IowaScaledEngineering/ckt-soundplay/doc/img/ckt-soundplay.png

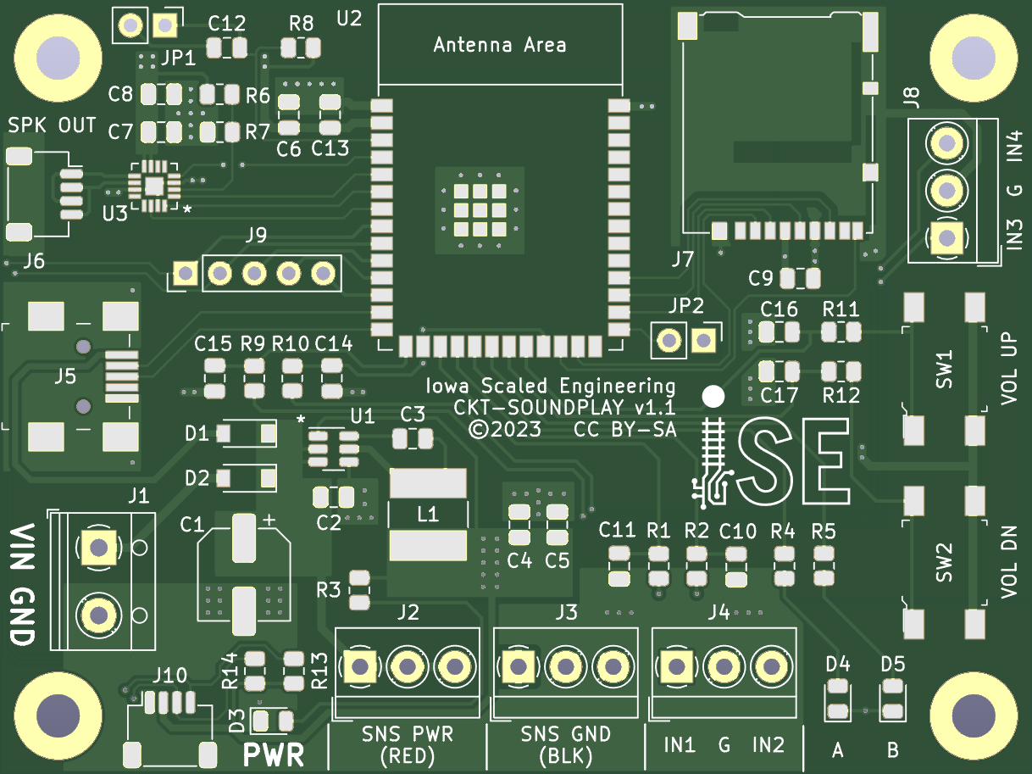
doc/img/ckt-soundplay.png
