IowaScaledEngineering/ckt-soundplay/pg/ckt-soundplay-test-v1.2-57295ef/ckt-soundplay-test-drc.txt

** Drc report for /tank/data/design/projects/ckt-soundplay/kicad/ckt-soundplay-test/ckt-soundplay-test.kicad_pcb **
** Created on 2023-08-12 13:44:06 **

** Found 0 DRC violations **

** Found 0 unconnected pads **

** Found 0 Footprint errors **

** End of Report **
