IowaScaledEngineering/ckt-soundplay/pg/ckt-soundplay-test-v1.2-57295ef/ckt-soundplay-test.pdf

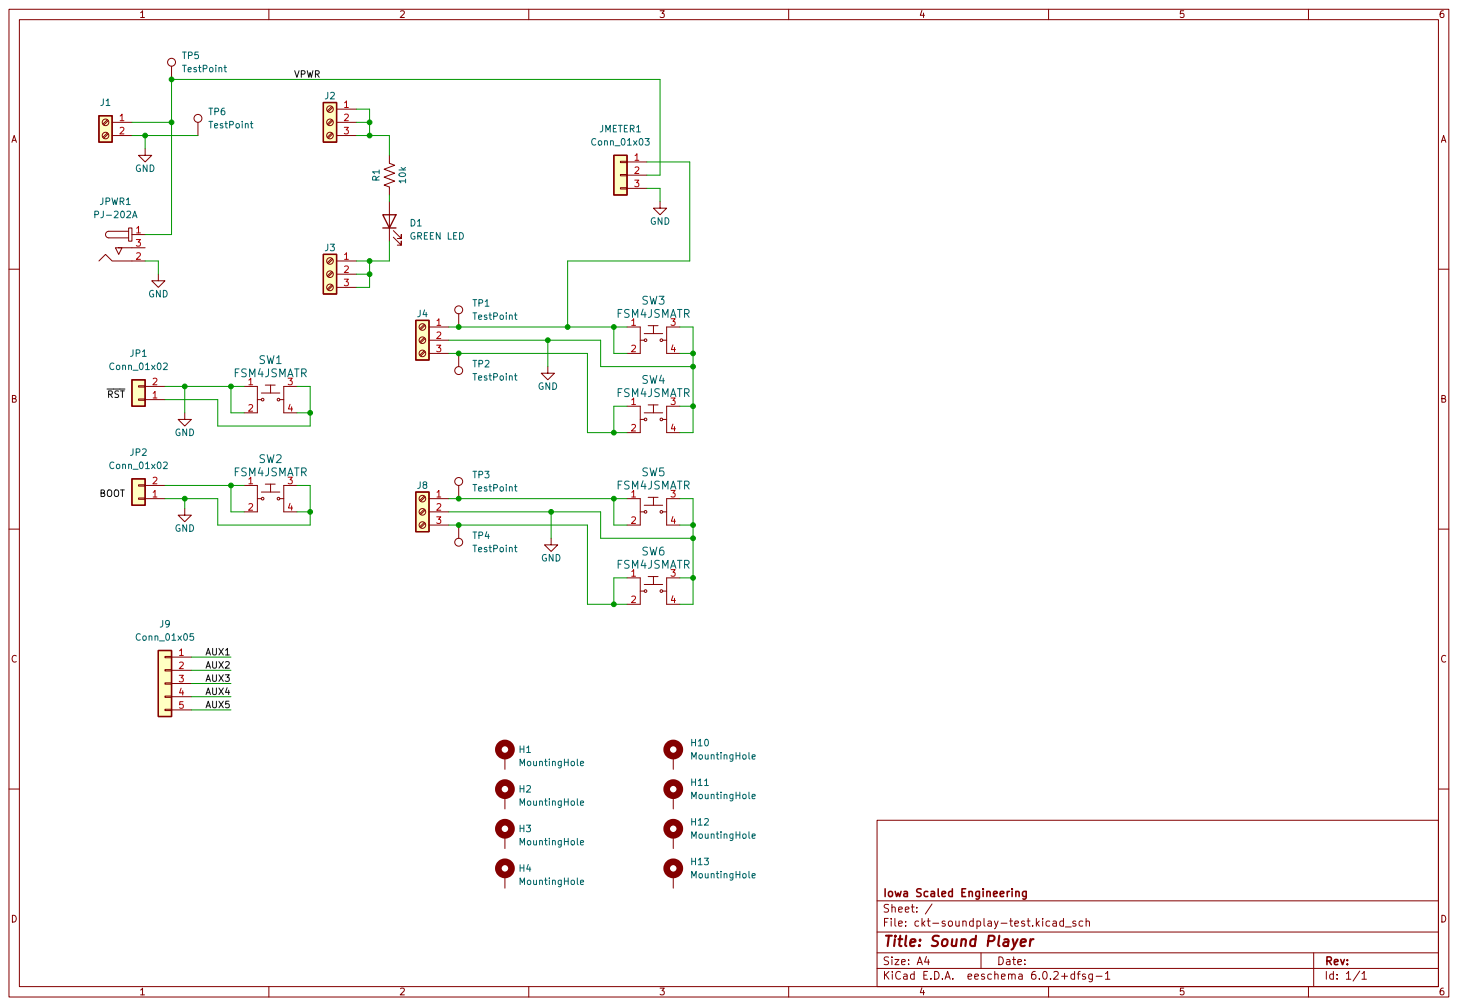
[picture p2: page 1]

H13 MountingHole H10 MountingHole H11 MountingHole H12 MountingHole H3MountingHole H4MountingHole H2MountingHole 123

File: ckt-soundplay-test.kicad_sch Sheet: /
Id: 1/1 Title: Sound Player
