IowaScaledEngineering/ckt-soundplay/pg/ckt-soundplay-v1.2-6501b10/ckt-soundplay.pdf

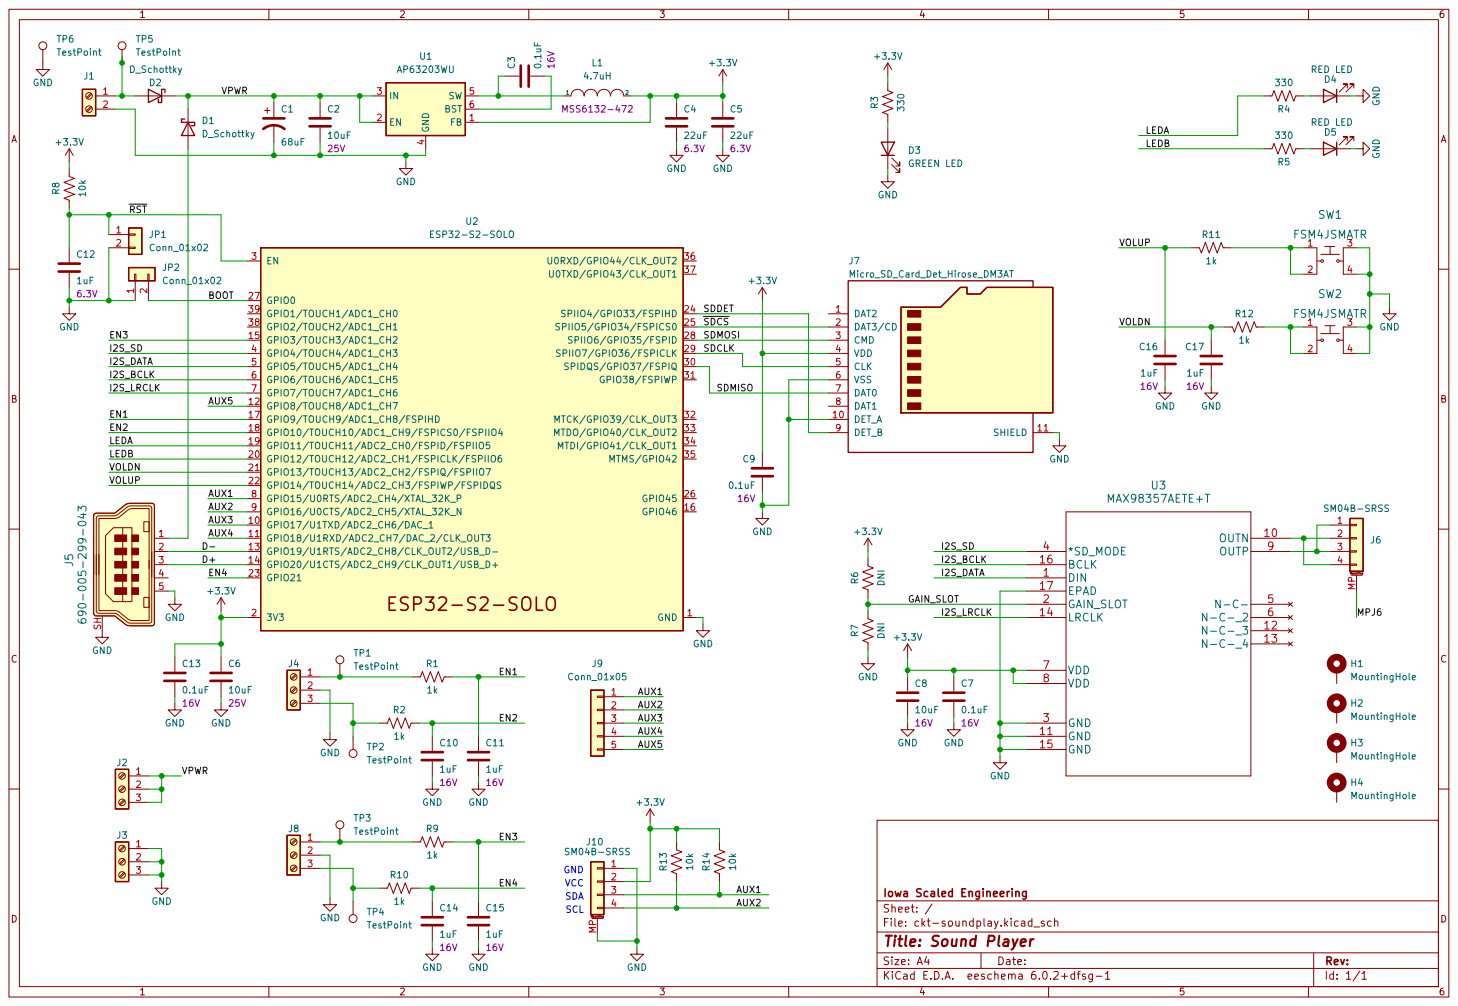
[picture p3: page 1]

File: ckt-soundplay.kicad_sch Sheet: /
Id: 1/1 Title: Sound Player
