IowaScaledEngineering/ckt-soundplay/pg/ckt-soundplay-array-v1.3-4f5287e/ckt-soundplay.pdf

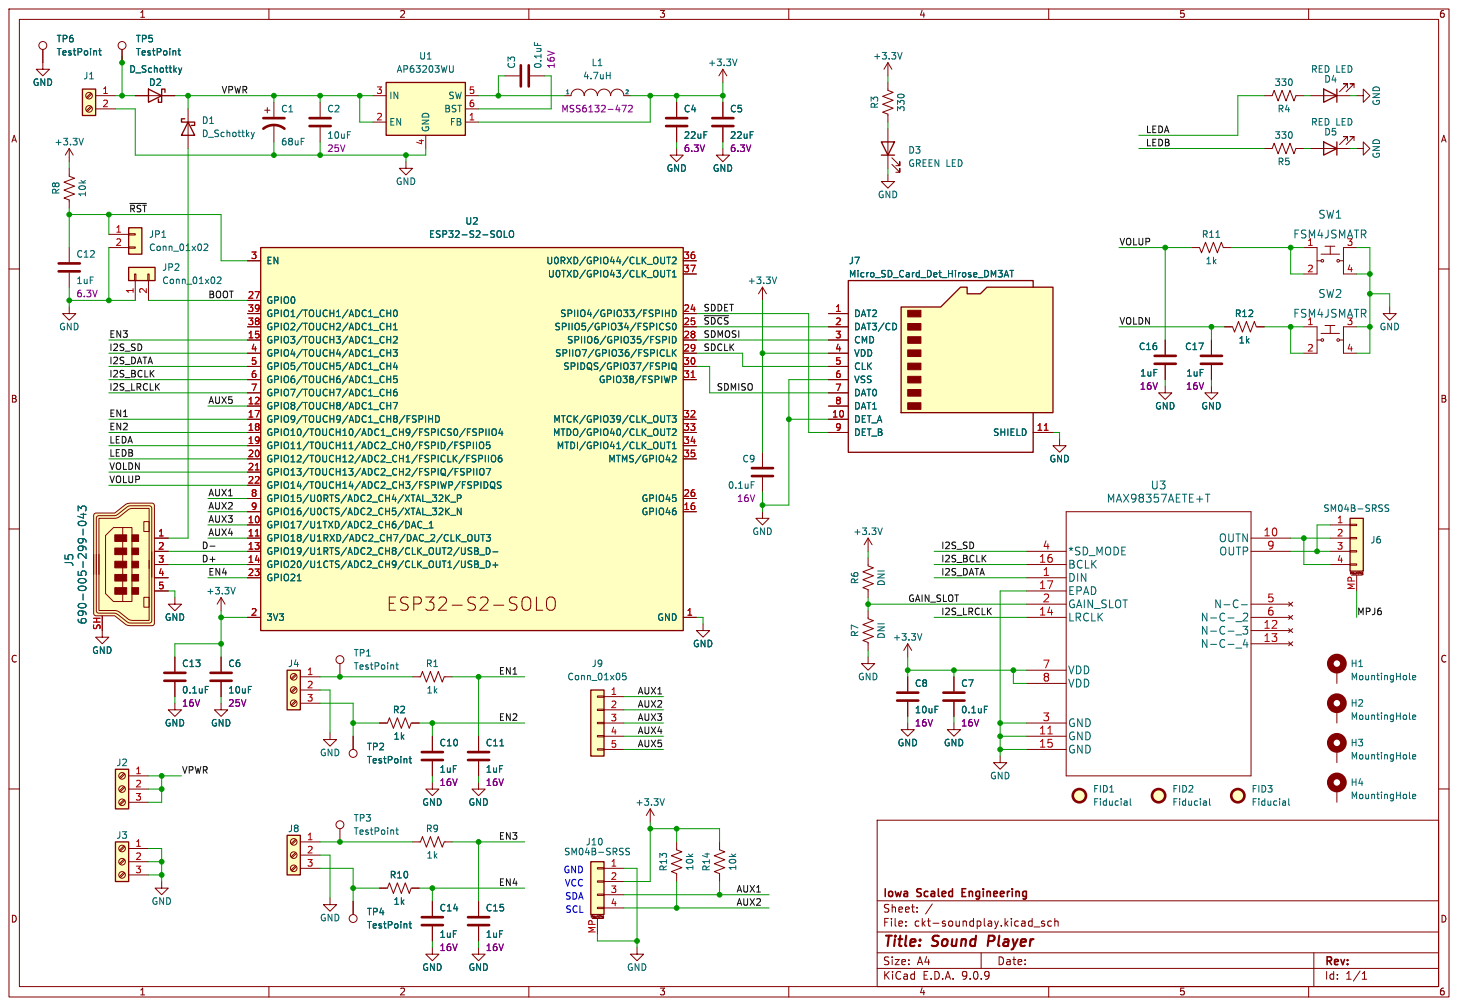
[picture p4: page 1]

EN 3 GPIO0 27 GPIO1/TOUCH1/ADC1_CH0 39 GPIO2/TOUCH2/ADC1_CH1 38 GPIO3/TOUCH3/ADC1_CH2 15 GPIO4/TOUCH4/ADC1_CH3 4 GPIO5/TOUCH5/ADC1_CH4 5 GPIO6/TOUCH6/ADC1_CH5 6 GPIO7/TOUCH7/ADC1_CH6 7 GPIO8/TOUCH8/ADC1_CH7 12 GPIO9/TOUCH9/ADC1_CH8/FSPIHD 17 GPIO10/TOUCH10/ADC1_CH9/FSPICS0/FSPIIO4 18 GPIO11/TOUCH11/ADC2_CH0/FSPID/FSPIIO5 19 GPIO12/TOUCH12/ADC2_CH1/FSPICLK/FSPIIO6 20 GPIO13/TOUCH13/ADC2_CH2/FSPIQ/FSPIIO7 21 GPIO14/TOUCH14/ADC2_CH3/FSPIWP/FSPIDQS 22 GPIO15/U0RTS/ADC2_CH4/XTAL_32K_P 8 GPIO16/U0CTS/ADC2_CH5/XTAL_32K_N 9 GPIO17/U1TXD/ADC2_CH6/DAC_1 10 GPIO18/U1RXD/ADC2_CH7/DAC_2/CLK_OUT3 11 GPIO19/U1RTS/ADC2_CH8/CLK_OUT2/USB_D- 13 GPIO20/U1CTS/ADC2_CH9/CLK_OUT1/USB_D+ 14 GPIO21 23

Id: 1/1 Title: Sound Player File: ckt-soundplay.kicad_sch Sheet: /
