IowaScaledEngineering/ckt-soundplay/pg/ckt-soundplay-test-v1.0-d255e98/ckt-soundplay-test.pdf

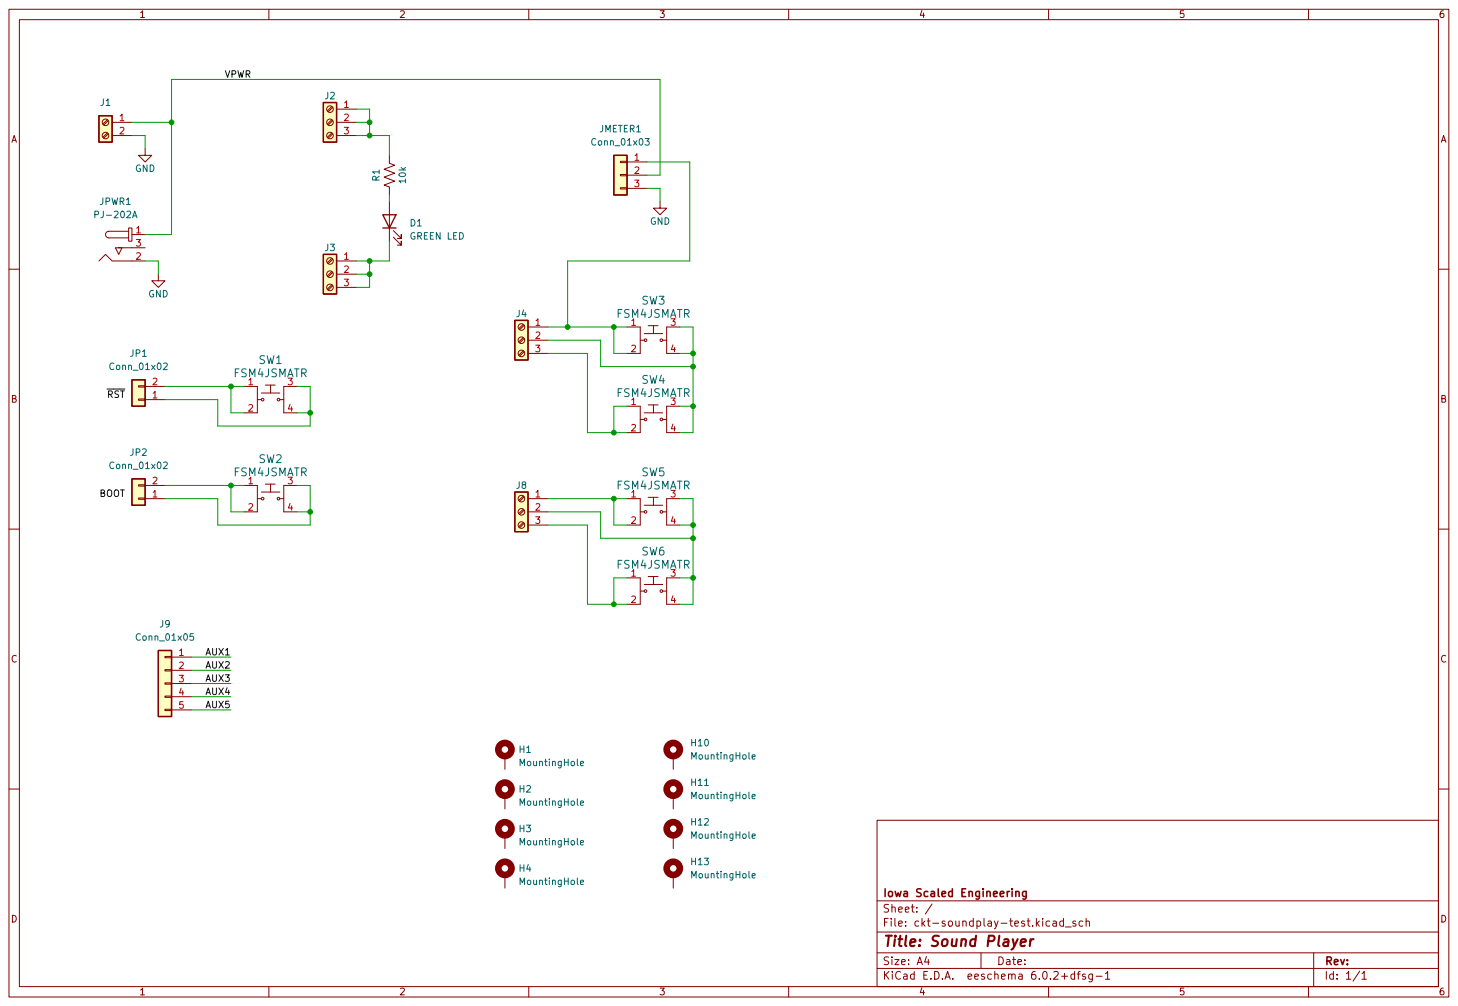
[picture p5: page 1]

Iowa Scaled Engineering
File: ckt-soundplay-test.kicad_sch Sheet: /
Id: 1/1 Title: Sound Player
