IowaScaledEngineering/ckt-soundplay/pg/ckt-soundplay-v1.1-f9cb04d/ckt-soundplay.pdf

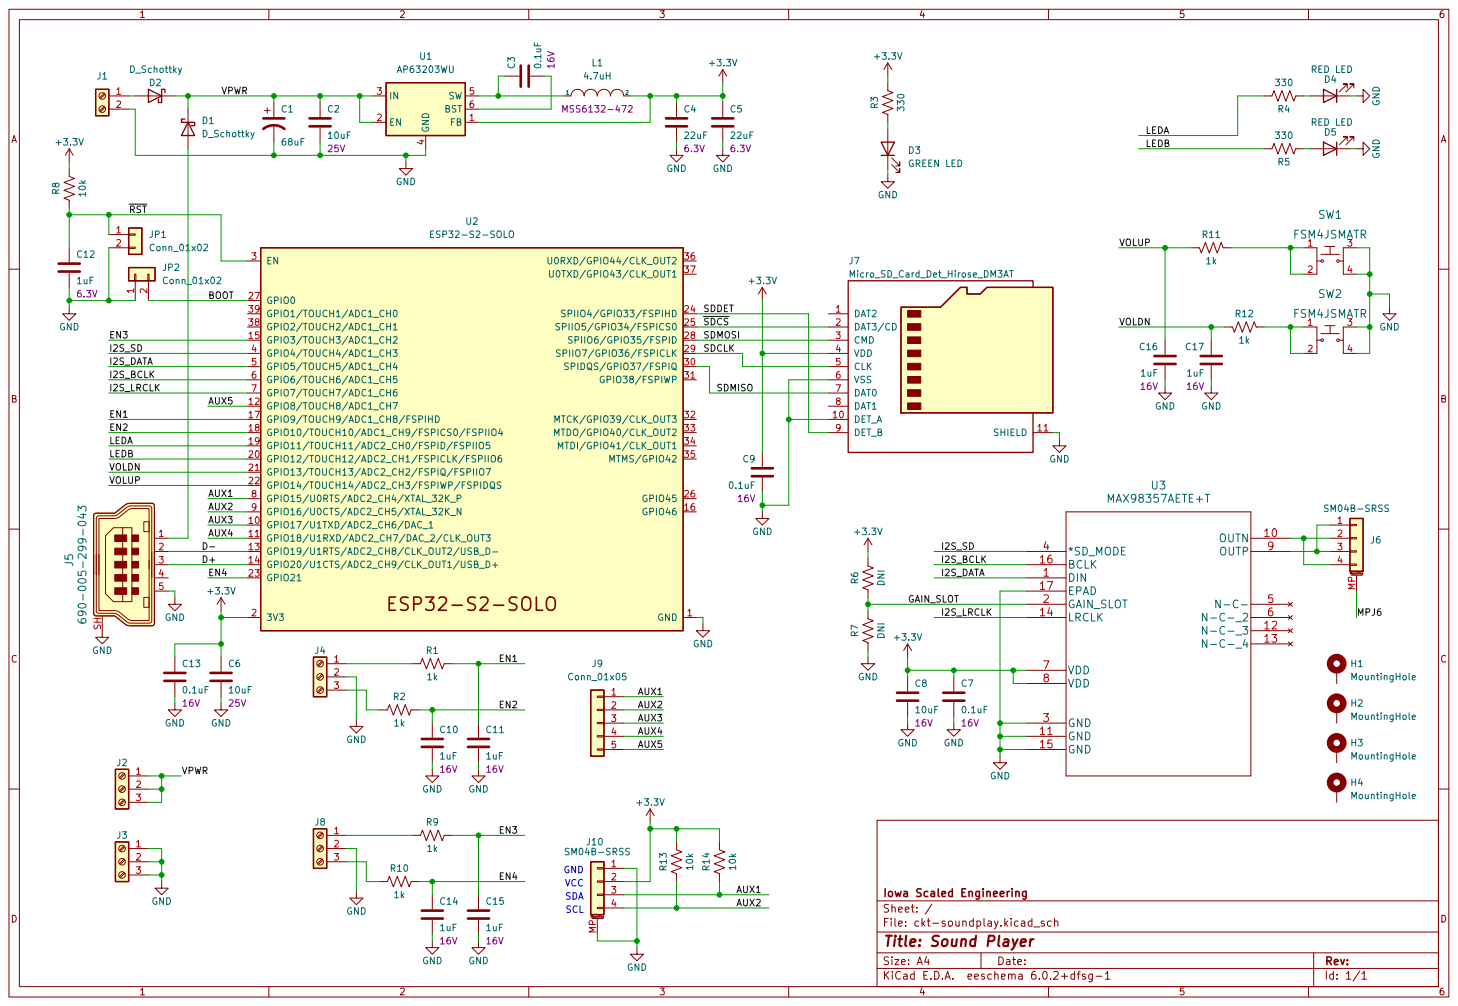
[picture p6: page 1]

SDMOSI
SDCLK

Iowa Scaled Engineering
File: ckt-soundplay.kicad_sch Sheet: /
Id: 1/1 Title: Sound Player
