IowaScaledEngineering/ckt-soundplay/pg/ckt-soundplay-v1.0-2696061/ckt-soundplay.pdf

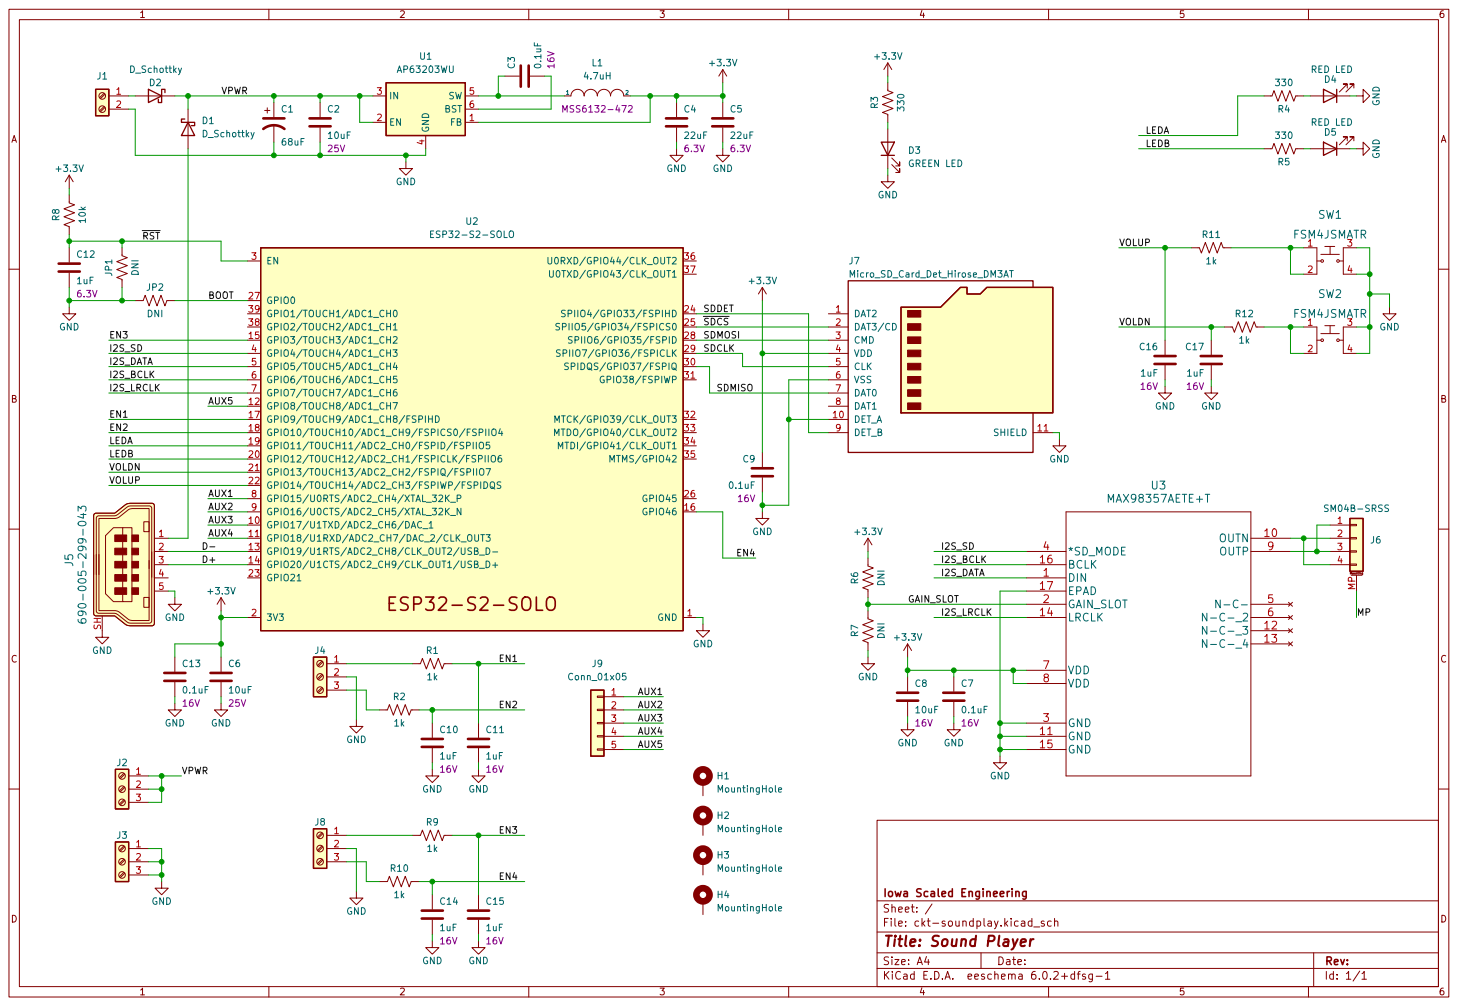
[picture p7: page 1]

Iowa Scaled Engineering
File: ckt-soundplay.kicad_sch Sheet: /
Id: 1/1 Title: Sound Player
