IowaScaledEngineering/ckt-soundplay/(commit log)

2022-11-19 Initial schematic
    [ckt-soundplay.kicad_pcb, ckt-soundplay.kicad_sch]
2022-11-19 Added mounting holes.
    [ckt-soundplay.kicad_sch]
2023-01-02 Initial board design
    [ckt-soundplay.kicad_pcb, ckt-soundplay.kicad_sch]
2023-01-02 Fixed R8/R9 labels
    [ckt-soundplay.kicad_pcb]
2023-01-02 Tweaked R7/D3 positions
    [ckt-soundplay.kicad_pcb]
2023-01-03 Fixed title block text
    [ckt-soundplay.kicad_pcb]
2023-01-03 Minor tweaks
    [ckt-soundplay.kicad_pcb]
2023-01-18 Initial ESP32 version
    [ckt-soundplay.kicad_sch]
2023-01-18 Added reset RC
    [ckt-soundplay.kicad_sch]
2023-01-18 Added reset and bootloader jumpers
    [ckt-soundplay.kicad_sch]
2023-02-21 Partial board update
    [ckt-soundplay.kicad_pcb, ckt-soundplay.kicad_sch]
2023-02-22 Initial layout, still missing I2S lines
    [ckt-soundplay.kicad_pcb, ckt-soundplay.kicad_sch]
2023-02-22 Improved 3.3V plane
    [ckt-soundplay.kicad_pcb]
2023-03-01 Added some net names and tweaked some routing/planes
    [ckt-soundplay.kicad_pcb, ckt-soundplay.kicad_sch]
2023-03-07 Swapped LRCLK and SD, power cleanup around I2S amp
    [ckt-soundplay.kicad_pcb, ckt-soundplay.kicad_sch]
2023-03-12 Added IN3/IN4
    [ckt-soundplay.kicad_pcb, ckt-soundplay.kicad_sch]
2023-03-12 Added J9
    [ckt-soundplay.kicad_pcb, ckt-soundplay.kicad_sch]
2023-03-12 Layout tweaks
    [ckt-soundplay.kicad_pcb]
2023-03-14 Added RC to VOL buttons. GND plane improvements.
    [ckt-soundplay.kicad_pcb, ckt-soundplay.kicad_sch]
2023-03-14 Minor text adjustments
    [ckt-soundplay.kicad_pcb]
2023-03-16 Fixed DRC that kibot found
    [ckt-soundplay.kicad_pcb]
2023-03-25 Sent to fab March 2023
    [ckt-soundplay-NPTH.drl, ckt-soundplay.drl, ckt-soundplay.gbl, ckt-soundplay.gbo, ckt-soundplay.gbp, ckt-soundplay.gbr, ckt-soundplay.gbs, ckt-soundplay.gm1]
2023-06-02 Rerouted IN4 Added I2C connector Added vias around input cap
    [ckt-soundplay.kicad_pcb, ckt-soundplay.kicad_sch]
2023-06-02 Added I2C pull-up resistors
    [ckt-soundplay.kicad_pcb, ckt-soundplay.kicad_sch]
2023-06-02 Changed JP1/2 to pin header holes.
    [ckt-soundplay.kicad_pcb, ckt-soundplay.kicad_sch]
2023-06-14 Test board
    [ckt-soundplay-test.kicad_pcb, ckt-soundplay-test.kicad_sch]
2023-06-22 Moved SDA/SCL inboard a little.
    [ckt-soundplay.kicad_pcb]
2023-06-22 Updated component locations and finished routing
    [ckt-soundplay-test.kicad_pcb]
2023-06-22 Fixed DRC error
    [ckt-soundplay.kicad_pcb]
2023-06-28 Sent to fab June 2023
    [ckt-soundplay-NPTH.drl, ckt-soundplay-test-NPTH.drl, ckt-soundplay-test.drl, ckt-soundplay-test.gbl, ckt-soundplay-test.gbo, ckt-soundplay-test.gbp, ckt-soundplay-test.gbr, ckt-soundplay-test.gbs]
2023-08-02 Added test points
    [ckt-soundplay.kicad_pcb, ckt-soundplay.kicad_sch]
2023-08-02 Added holes for test points and rewired slightly
    [ckt-soundplay-test.kicad_pcb, ckt-soundplay-test.kicad_sch]
2023-08-04 Updated rev number
    [ckt-soundplay.kicad_pcb]
2023-08-12 Bumped rev to 1.2
    [ckt-soundplay-test.kicad_pcb]
2023-08-12 v1.2 fab files
    [ckt-soundplay-NPTH.drl, ckt-soundplay-test-NPTH.drl, ckt-soundplay-test.drl, ckt-soundplay-test.gbl, ckt-soundplay-test.gbo, ckt-soundplay-test.gbp, ckt-soundplay-test.gbr, ckt-soundplay-test.gbs]
2026-09-01 Update footprints to modern stuff (like the SOD123 diodes) and fix a bunch of stuff that DRC doesn't like under Kicad 9 Update version to 1.2A, since nothing really changed or moved
    [ckt-soundplay.kicad_pcb, ckt-soundplay.kicad_sch]
2026-09-01 Panelization pieces
    [ckt-soundplay.kicad_pcb]
2026-09-01 Panelized sound players
    [ckt-soundplay-array.kicad_pcb]
2026-09-01 Update to 1.3 instead of 1.2A because Michael
    [ckt-soundplay-array.kicad_pcb, ckt-soundplay.kicad_pcb]
2026-09-01 Update footprint, recreate panel
    [ckt-soundplay-array.kicad_pcb, ckt-soundplay.kicad_pcb, ckt-soundplay.kicad_sch]
2026-09-01 Update panel - new QFN, move fiducial
    [ckt-soundplay-array.kicad_pcb, ckt-soundplay.kicad_pcb]
2026-09-01 PG array of 1.3
    [ckt-soundplay-array-NPTH.drl, ckt-soundplay-array.drl, ckt-soundplay-array.gbl, ckt-soundplay-array.gbo, ckt-soundplay-array.gbp, ckt-soundplay-array.gbr, ckt-soundplay-array.gbs, ckt-soundplay-array.gm1]
