IowaScaledEngineering/ckt-soundplay/(notices)

Notices in the files:
kicad/ckt-soundplay/ckt-soundplay.kicad_pcb:
©2026 CC BY-SA
parts and their libraries:
Copyright 2021 Accelerated Designs. All rights reserved.
